TheMonado2/GrowIoT-Smart-Greenhouse/README.md

# GrowIoT-Smart-Greenhouse
Smart Greenhouse powered by an ESP-32 and the Arduino IoT Cloud
